AigarciabFabero/Medidor-de-temperatura-industrial-digital-con-microcontrolador/Others/Ampli+puente.asc

R1: res; 25k
R2: res; 1k
R3: res; 17k
R4: res; 1k
R5: res; 1k
R6: res; {Rp}
R7: res; 250
R8: res; 36.3
R10: res; 25k
R20: res; 1k
R30: res; 17k
R: res; 1500.9
U1: LM358
U2: LM358
U3: LM358
U4: LM358
V10: voltage; 5
Named nets: vo, Vcc+, Vcc-, 0, V22, V11
.tran 0 1 0
Alimentación de los amplificadores
.step param Rp 248.439 250.46 0.25
